Tugo812/Buoyancy-Engine/(commit log)

2026-10-10 Enhance README with project details and specifications
    Added project description and technical details about the prototype, including the design, programming, and components used.
2026-10-10 Remove duplicate content in README.md
    Removed duplicate lines describing the prototype and its features.
2026-10-10 Revise README with project details and design choices
    Updated project description and details about the prototype.
